rodrisebok/Kernel_Panic_Game/docs/guia_armado.html

# GUÍA DE ARMADO

Kernel Panic · control con cable y consola en protoboard

0 de 7 pasos

El proyecto tiene dos partes. El control va en la mano: el joystick y el botón de ataque, unidos al Arduino UNO con un cable de 6 hilos. La consola queda sobre la mesa: el UNO, el NodeMCU, el protoboard con la barra de LEDs y el buzzer. Cada placa se alimenta con su propio cable USB (notebook, cargador de celular o power bank). Armá y probá una parte por vez: cada paso termina con una prueba.

## Reglas para no quemar nada

1. Cableá con todo desconectado: sin ningún USB enchufado.
2. El 5 V nunca entra al protoboard. Las filas de alimentación son solo de 3,3 V (del pin 3V3 del NodeMCU). El 5 V del UNO va únicamente al joystick, con un cable directo.
3. A un pin de señal del ESP nunca le llegan 5 V. Lo único que viene del UNO a un pin de señal es el TX, y pasa por el divisor de tensión.
4. GND común: el GND del UNO y el del ESP unidos.
5. Cada placa con su USB. No unas el 5V del UNO con el VIN ni con el 3V3 del NodeMCU, y no uses la pila de 9V. Así nunca hay dos fuentes peleando.

## Lo que vas a usar

- El control
- 1Joystick HW-504
- 1Pulsador de ataque (si podés, de 12 mm con capuchón o un botón de arcade)
- 6Cables macho-hembra largos (30 a 50 cm)
- 1Tablita, cartón duro o protoboard mini como base
- La consola
- 1Arduino UNO y NodeMCU ESP8266, con sus cables USB
- 1Protoboard de 60 columnas
- 174HC595 y 8 LEDs (3 rojos, 5 amarillos)
- 8Resistencias de 220 Ω (rojo, rojo, marrón)
- 3Resistencias de 1 kΩ (marrón, negro, rojo)
- 1Buzzer
- 2Cables USB (uno por placa) y dónde enchufarlos: notebook, cargador doble o power bank de 2 salidas
- ~20Cables macho-macho

## Mapa de voltajes: dos zonas que se tocan en solo dos puntos

Ningún cable de alimentación cruza de una placa a la otra. El punto ① es seguro porque el divisor baja los pulsos de 5 V del UNO a 3,3 V. El punto ② (GND común) es obligatorio: sin él el ESP no entiende los datos. El ESP nunca le manda nada al UNO, así que no hay riesgo en el otro sentido.

3,3 V 5 V (solo zona UNO) GND Señal Control del 595 Analógica A los LEDs

### Vista del protoboard de la consola

Así queda la consola armada, vista desde arriba. Las columnas van de 1 a 60 y las filas de la a a la e (arriba) y de la f a la j (abajo). El UNO y el control quedan afuera del protoboard; del UNO llegan solo dos cables: TX y GND. Los nombres de los pines del NodeMCU pueden variar entre clones: confirmalos con lo impreso en tu placa.

Ojo con tu protoboard: del lado de los LEDs, la fila + (línea roja) es la de adentro y la − (línea azul) la de afuera, como en el dibujo. Guiate siempre por el color de la línea, no por la posición. Si la línea roja y la azul están cortadas a la mitad del protoboard, las filas están partidas en dos: uní cada mitad con un cable corto (rojo con rojo y azul con azul), como los dos puentes de la columna 30. Si no estás seguro, ponelos igual: no molestan.

## Alimentación

a5 → fila + arriba | 3V3 del NodeMCU
a6 → fila − arriba | GND del NodeMCU
j1 → fila + abajo | 3V3 del NodeMCU
j2 → fila − abajo | GND del NodeMCU
USB del NodeMCU | Alimenta todo el protoboard

## 74HC595 (muesca a la derecha)

a19 → fila − arriba | pata 8 · GND
j26 → fila + abajo (roja) | pata 16 · VCC
j20 → fila + abajo | pata 10 · MR
j23 → fila − abajo | pata 13 · OE
j6 → i24 | D7 → pata 14 · DS
j5 → i21 | D8 → pata 11 · SH_CP
j15 → h22 | D0 → pata 12 · ST_CP

## LEDs (columnas 29, 31, 33… 43: una sí, una no)

g25 → c29 | Q0 → LED 1 (rojo)
d26 → d31 | Q1 → LED 2 (rojo)
c25 → c33 | Q2 → LED 3 (rojo)
d24 → d35 | Q3 → LED 4
c23 → c37 | Q4 → LED 5
b22 → b39 | Q5 → LED 6
d21 → d41 | Q6 → LED 7
b20 → b43 | Q7 → LED 8
e · f | LED cruzando el canal: pata larga en e, pata corta en f
j → fila − abajo (azul) | 220 Ω de cada LED a GND

## Buzzer y divisor

h46 · h49 | buzzer: + en 46, − en 49
j7 → j46 | D6 → buzzer +
j49 → fila − abajo | buzzer −
j52 ← TX del UNO | cable desde el pin 1 del UNO
i52 → i54 · g54 → g56 | 1 kΩ cada una
j56 → fila − abajo | 1 kΩ
h54 → j13 | punto de unión → D2
fila − abajo, col. 59 ← GND del UNO | GND común
d58 · d60 · g58 · g60 | botón de disparo, sobre la ranura
a58 ← pin 3 del UNO | una pata del botón
j60 → fila − abajo | la pata en diagonal, a GND

1

### Base: NodeMCU y filas de 3,3 V

Paso terminado

#### Qué hacer

- Pinchá el NodeMCU sobre el canal central, en las columnas 1 a 15, con el USB hacia afuera.
- Si tu NodeMCU es de los anchos (por ejemplo, LoLin V3) y tapa todos los agujeros, usá dos protoboards juntos, uno debajo de cada fila de pines.
- Uní 3V3 con la fila + y GND con la fila −, arriba y abajo.

#### Probalo

Conectá el USB, elegí la placa NodeMCU 1.0 (ESP-12E Module) y cargá la Prueba 1. Si se carga sin error, la placa funciona.

#### Si falla

- No aparece el puerto: instalá el driver CH340 o CP2102, según el chip que esté al lado del USB.
- Probá con otro cable USB: algunos solo cargan y no transmiten datos.

2

### 74HC595 y barra de 8 LEDs

Paso terminado

#### Qué hacer

- Pinchá el 74HC595 cruzando el canal central, en las columnas 19 a 26, con la muesca hacia la derecha. Seguí las posiciones de la vista del protoboard.
- Alimentación: patas 16 y 10 a 3,3 V. Patas 8 y 13 a GND.
- Control: 14 → D7, 11 → D8, 12 → D0.
- LEDs en las columnas 29, 31, 33, 35, 37, 39, 41 y 43 (una sí, una no, porque los LEDs son más anchos que una columna): cada LED cruza el canal: pata larga en la fila e, pata corta en la f. Después, una resistencia de 220 Ω desde la fila j de esa columna hasta la fila − (azul) de abajo; sus patas largas pasan por encima de la fila +.

#### Probalo

Cargá la Prueba 1. Los LEDs se encienden de a uno, de Q0 a Q7, vuelven, y después se prenden todos juntos.

#### Si falla

- No enciende ninguno: revisá las patas 16 y 8, la 13 en GND y la 10 en 3,3 V.
- No enciende uno solo: está al revés o le falta su resistencia.
- Se encienden desordenados: D7, D8 y D0 están intercambiados.
- El programa no se carga con todo conectado: desconectá D8, cargá y volvé a conectarlo.

3

### Buzzer

Paso terminado

#### Qué hacer

- Buzzer en las columnas 46 a 49: pata + en la 46, conectada a D6.
- Pata − en la 49, conectada a la fila de GND.

#### Probalo

Cargá la Prueba 2: suena una escala y la melodía de "game over". Si suena siempre el mismo pitido, el buzzer es activo: sirve igual, pero sin melodías.

#### Si falla

- Si no suena, dalo vuelta: en los buzzers activos importa la polaridad.

4

### El control: joystick, botón y cable al UNO

Paso terminado

#### Qué hacer

- Montá el joystick a la izquierda y el botón a la derecha de una tablita, un cartón duro o un protoboard mini, como un gamepad. El HW-504 tiene 4 agujeros para atornillarlo o pegarlo.
- Con cables macho-hembra largos: GND → GND, +5V → 5V, VRx → A0, VRy → A1, SW → 2.
- Botón de disparo: sus patas son cortas para tenerlo en la mano, así que va en el protoboard, sobre la ranura, en las columnas 58 y 60 (ver la vista del protoboard). Desde la línea de una pata, un cable al pin 3 del UNO; desde la línea de la pata en diagonal, un cable a la fila − azul.
- Pines digitales del UNO: 0 vacío, 1 divisor (paso 5), 2 SW, 3 botón.
- Encintá los 5 cables del joystick juntos cada 10 cm para que queden como un solo cable.
- Todavía no conectes nada entre el UNO y el ESP.

Pulsadores de 4 patas: usá dos patas en diagonal. Así siempre funcionan como interruptor, sin importar cómo lo pongas.

#### Probalo

Cargá JoystickUNO en el UNO (placa: Arduino Uno) y abrí el Monitor Serie a 38400. Con todo quieto deberías ver algo como 519,507,1,1. Cada eje llega a 0 y a 1023 en los extremos. Al hundir la palanca, el tercer número pasa a 0; al apretar el botón de ataque, el cuarto.

#### Si falla

- Se ven símbolos raros: el Monitor Serie no está en 19200.
- X e Y están cambiados: intercambiá los cables de A0 y A1.
- Un eje va al revés: lo corregís en el paso 7 con INVERTIR_X o INVERTIR_Y.
- El botón siempre da 1: revisá que esté en el pin 3 (no en el 2), que cada cable esté en la misma línea que una pata y que la otra pata vaya a GND.
- El botón siempre da 0: los dos cables quedaron en patas unidas por dentro. Girá el botón un cuarto de vuelta.
- X e Y quedan en 1023: falta el GND del joystick o está flojo.

5

### Comunicación UNO → ESP: divisor de tensión y GND común

Paso terminado

#### Qué hacer

- TX del UNO (es el pin 1, no el 0) → columna 52 del protoboard → 1 kΩ → punto de unión (columna 54).
- Del punto de unión → D2 del NodeMCU.
- Del punto de unión → 1 kΩ → 1 kΩ → GND.
- GND del UNO → fila − del protoboard.

Por qué: el UNO manda pulsos de 5 V y el ESP aguanta 3,3 V. Las tres resistencias reparten el voltaje: 5 V × 2 kΩ / 3 kΩ ≈ 3,3 V.

#### Probalo

Conectá los dos USB. Cargá la Prueba 5 en el ESP y abrí su Monitor Serie a 115200. Deberías ver líneas como X= 519 Y= 507 SW=1 BOTON=1 → CENTRO, que cambian al mover la palanca y al apretar el botón.

#### Si falla

- No llega nada: revisá el GND común y que el cable salga del pin 1 (TX).
- Aparece "Línea con error" muy seguido: hay un cable flojo.

6

### Alimentación: un USB para cada placa

Paso terminado

#### Qué hacer

- El UNO va con su cable USB (el de impresora, tipo B) y el NodeMCU con el suyo (micro-USB).
- Enchufá los dos a la misma notebook, a un cargador doble o a un power bank de 2 salidas.
- No hay cable de 5V a VIN ni pila de 9V. Entre las placas pasan solo los dos cables del paso 5: TX (por el divisor) y GND.
- Pegá el UNO al lado del protoboard con cinta doble faz, para que los cables no tironeen.

Ventaja: para cargar programas no hay que desconectar nada; cada placa ya está en su USB.

#### Probalo con el tester

Con los dos USB enchufados: entre la fila + del protoboard y la fila − tiene que dar cerca de 3,3 V. En el punto de unión del divisor (columna 54) y GND tiene que dar entre 3 y 3,4 V mientras el UNO transmite, nunca más de 3,6 V.

#### Si falla

- El ESP se reinicia solo: probá otro cable micro-USB (algunos son finitos y pierden tensión) o otra salida del cargador.
- El power bank se apaga solo: algunos se cortan con poco consumo. Usá la notebook o un cargador de pared.
- La página dice "UNO sin señal": revisá el GND común y el divisor (paso 5).

7

### Todo junto: cargar el juego

Paso terminado

#### Qué hacer

- En config.h, poné el nombre y la clave de la red Wi-Fi.
- Conectá el USB del NodeMCU a la compu y cargá el firmware del juego. El Monitor Serie (115200) muestra la dirección IP.
- Para jugar podés dejar los dos USB en la notebook, o pasarlos a un cargador doble o power bank.
- Abrí la IP en el celular o la PC, conectados a la misma red. Si el ESP no encuentra la red, crea la suya: KernelPanic-ESP, clave kernelpanic, en http://192.168.4.1.
- Durante los primeros segundos dejá el joystick quieto: el ESP mide el centro.

#### Probalo

En el panel "Hardware en vivo" de la página tiene que decir UNO conectado. El punto del joystick sigue a la palanca y la barra de LEDs de la página coincide con la real.

#### Si falla

- Dice "UNO sin señal": volvé al paso 5.
- El personaje va al revés: poné INVERTIR_X o INVERTIR_Y en 1 en config.h.

### Referencia rápida de pines

## NodeMCU ESP8266 (consola)

Pin | Va a
USB | Alimentación (su propio cable)
3V3 | Filas + del protoboard: 595 (16 y 10)
GND | Filas −: 595 (8 y 13), LEDs, buzzer, divisor, GND del UNO
D2 | Punto de unión del divisor (datos del UNO)
D6 | Buzzer +
D7 | 595 pata 14 (DS)
D8 | 595 pata 11 (SH_CP)
D0 | 595 pata 12 (ST_CP)

## Arduino UNO (control)

Pin | Va a
USB | Alimentación (su propio cable)
5V | Solo el +5V del joystick
GND | Joystick, botón y GND del ESP
A0 / A1 | Joystick VRx / VRy
2 | Joystick SW
3 | Botón de disparo (otra pata a GND)
0 (RX) | Vacío (lo usa el USB)
1 (TX) | 1 kΩ → divisor → D2 del ESP
