rodrisebok/Kernel_Panic_Game/pruebas/Prueba6_Juego_completo/LEEME.md

# Prueba 6 · Juego completo con página web

Esta prueba usa los programas finales, no un sketch de prueba:

- **Arduino UNO:** `arduino_uno/JoystickUNO`
- **NodeMCU ESP8266:** `firmware/KernelPanic` (antes, poné el nombre y la clave de tu Wi-Fi en `config.h`)

Abrí el Monitor Serie a 115200, entrá desde el navegador a la dirección que aparece y jugá una partida completa: la intro, las 4 zonas, el jefe con sus dos fases, ganar y perder. Revisá que los LEDs y el buzzer respondan en cada evento.

El resultado y los problemas que aparecieron están en `docs/pruebas.md`.
