rodrisebok/Kernel_Panic_Game/(commit log)

2026-11-02 Prototipo del juego, programa del UNO, pruebas, guía de armado y póster
2026-11-02 Simulación del circuito en Wokwi con protoboard
2026-11-10 Prueba 1 superada: LEDs con el 74HC595; bitácora de pruebas
2026-11-10 Simulación en Cirkit Designer (Arduino UNO + ESP32-S3)
2026-11-10 Prueba 2 superada: buzzer con el Tema de Kernel Panic
    [Prueba2_Buzzer.ino]
2026-11-10 Guía de armado: botón de disparo en el protoboard y pines del UNO
2026-11-10 Prueba 3 superada: joystick y botón de disparo en el Arduino UNO
2026-11-10 Prueba 4 superada: divisor de tensión medido (4,40 V → 2,93 V)
2026-11-12 Prueba 5 superada: el ESP8266 recibe el joystick desde el UNO
2026-11-13 Firmware del juego de plataformas para el ESP8266
2026-11-13 Nueva temática: K-1T es una IA y el jefe final es NÚCLEO-0
2026-11-13 UART más robusto: 19200 baudios y número de verificación en cada línea
2026-11-13 Opción para disparar con el pulsador del joystick (DISPARO_CON_SW)
2026-11-13 Intro con la historia al estilo cinemática; se quitan los textos de la página
    Claude-Session: https://claude.ai/code/session_01AksFk4ATvTw89ez4osjFAV
2026-11-13 NÚCLEO-0 con dos fases: escudo al llegar a la mitad de la vida y fase 2 más rápida
    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
2026-11-13 Prueba 6 superada; póster actualizado (UART 19200, intro, jefe con dos fases, captura nueva)
    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
2026-11-14 Simulación Cirkit: UART a 19200 y valor de control, igual que el circuito real
    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
2026-11-14 Imagen del circuito de Cirkit en el README; link de la simulación en el póster
    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
2026-11-14 Se quita la simulación de Wokwi: la simulación es la de Cirkit Designer
    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
2026-11-14 README: se reemplaza el texto de la historia por la descripción del proyecto
    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
2026-11-14 Póster: figura 4 con el circuito de Cirkit recortado y tamaños ajustados para el título en dos renglones
    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
2026-11-14 README: foto de la medición del divisor de tensión con el tester
    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
2026-11-14 Pruebas numeradas igual que la bitácora: 4 (divisor, con tester), 5 (UART) y 6 (juego completo)
    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
2026-11-14 Repaso del repositorio: se quitan repetidos y lo que sobraba
    - pagina.html (era una copia de pagina.h)
    - la imagen del circuito repetida en docs/ (queda la de poster/logos)
    - la vista previa del póster (tenía logo y colores de prueba)
    - el código para ESP32/Wokwi dentro del firmware
    - textos desactualizados: ArduinoJson, 38400 baudios, "virus", número de la prueba de UART
    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
2026-11-14 README: se quitan las explicaciones para la defensa
    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
2026-11-14 README: se quitan problemas menores de la tabla
    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
2026-11-14 README: foto del proceso de armado del circuito
    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
2026-11-14 README: primero el armado y después las pruebas
    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
2026-11-14 README: tabla de estado en el orden en que se desarrolló el proyecto
    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
2026-11-14 README: foto del prototipo terminado junto a la del proceso de armado
    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
2026-11-14 README: el diseño del circuito en Cirkit va antes del armado
    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
2026-11-14 README: contenido del repositorio en el orden de desarrollo
    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
